igorlab/ph-simulator/docs/schematic.png

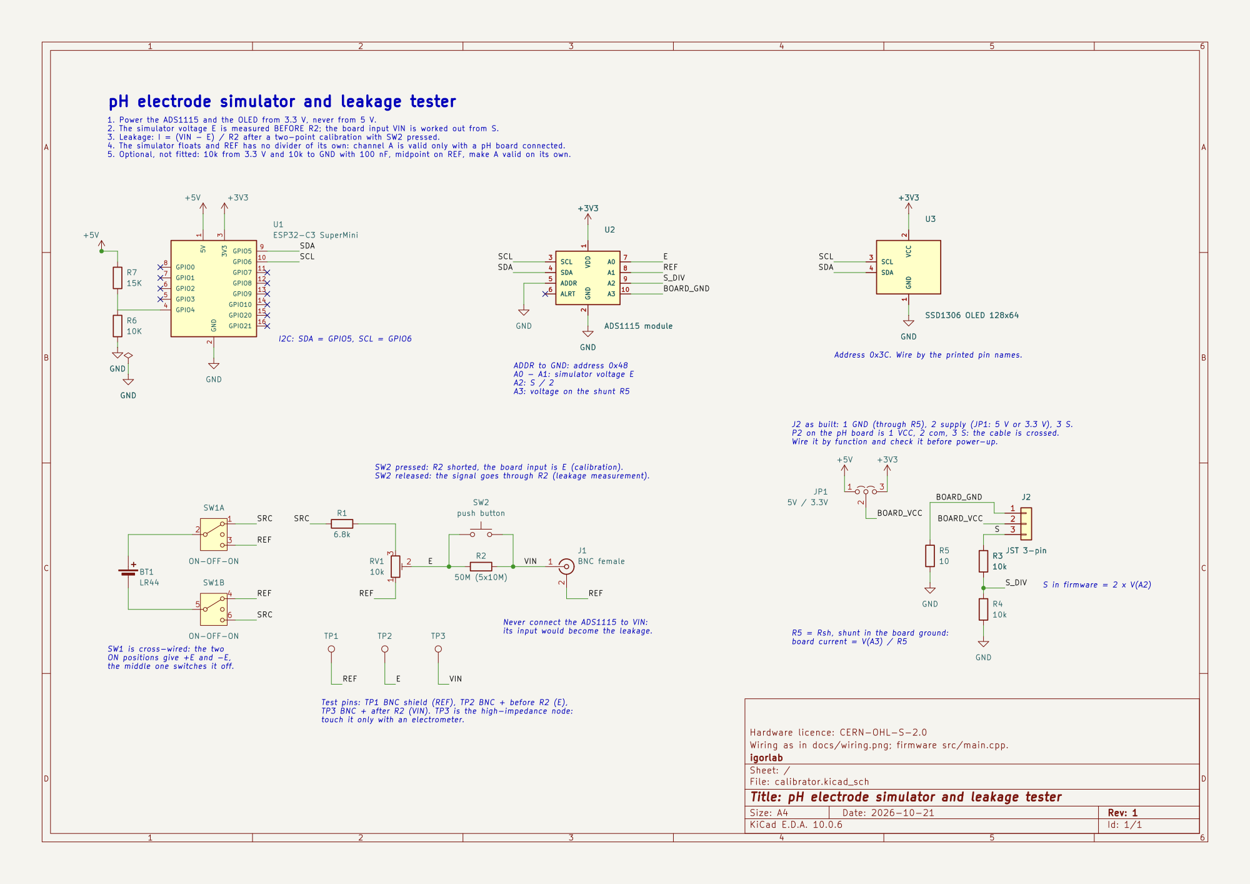
docs/schematic.png
