igorlab/ph-simulator/docs/schematic.pdf

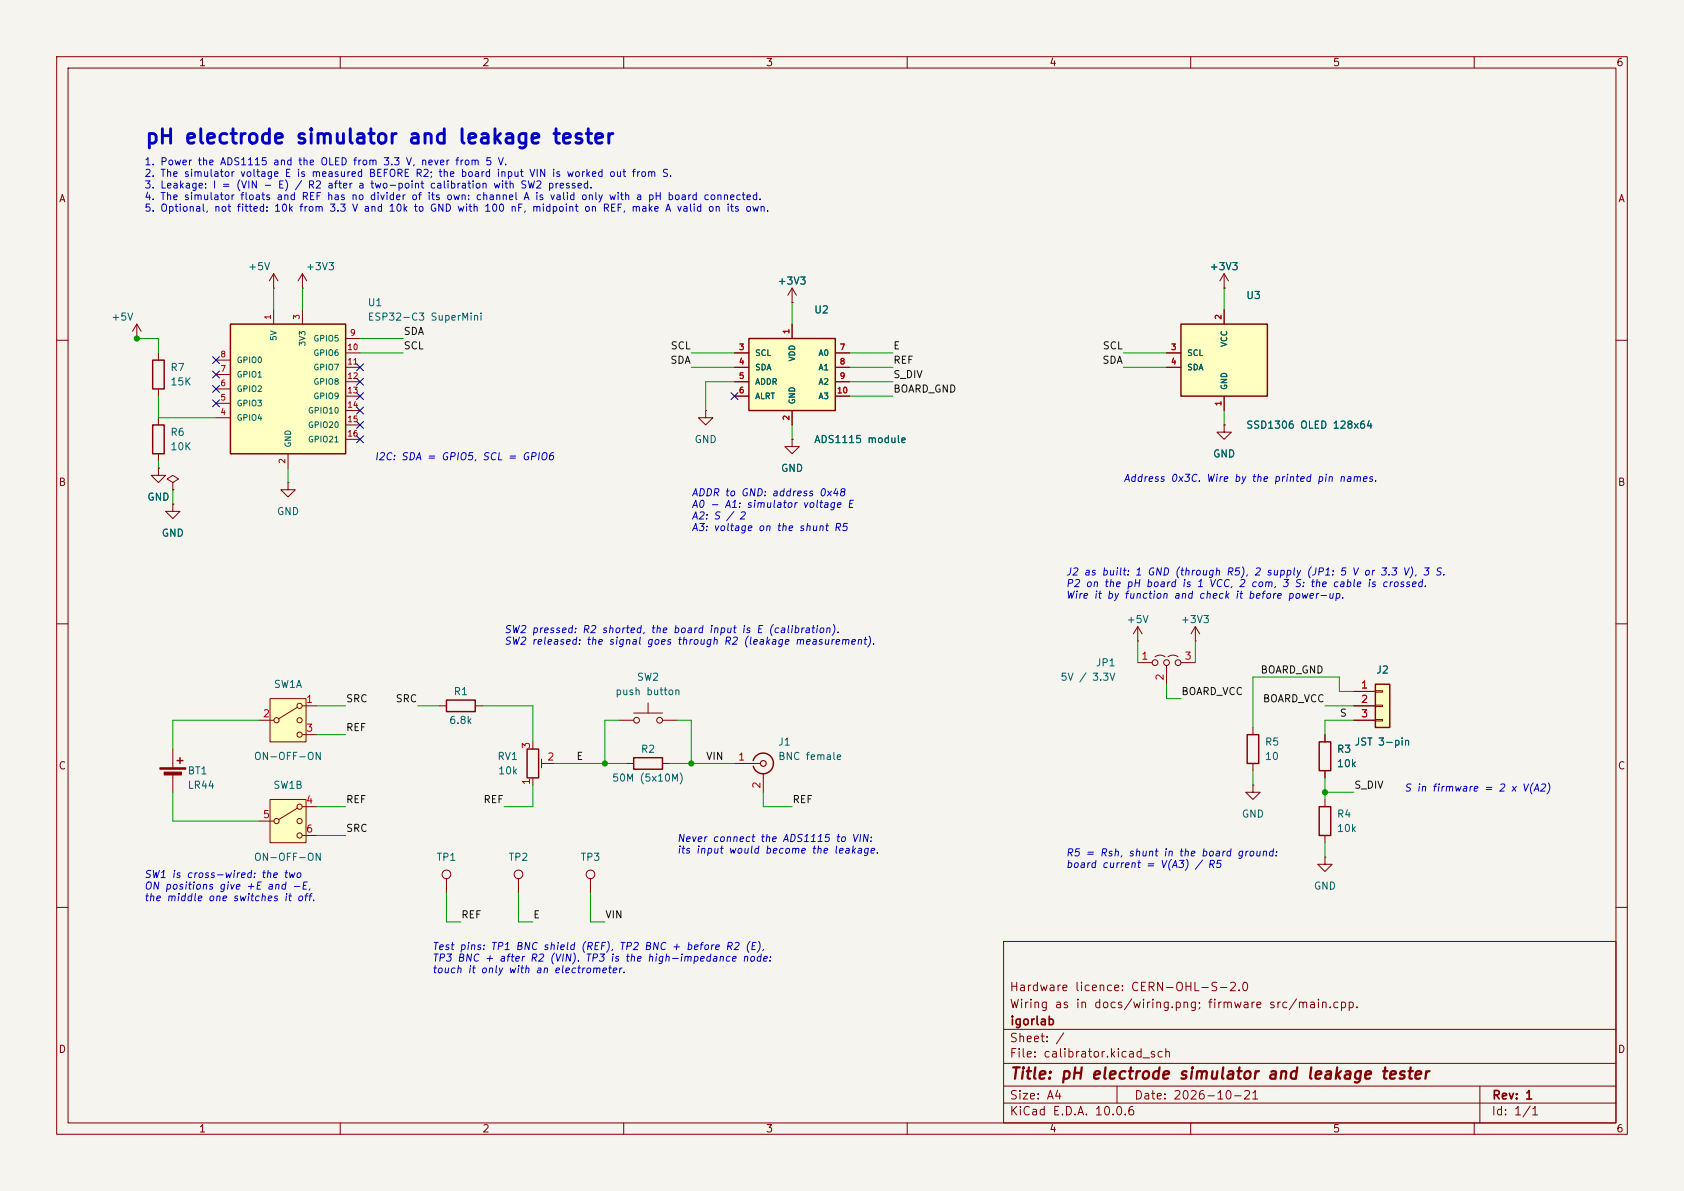
[picture p3: page 1]

1. Power the ADS1115 and the OLED from 3.3 V, never from 5 V. 2. The simulator voltage E is measured BEFORE R2; the board input VIN is worked out from S. 3. Leakage: I = (VIN - E) / R2 after a two-point calibration with SW2 pressed. 4. The simulator floats and REF has no divider of its own: channel A is valid only with a pH board connected. 5. Optional, not fitted: 10k from 3.3 V and 10k to GND with 100 nF, midpoint on REF, make A valid on its own. pH electrode simulator and leakage tester

its input would become the leakage. Test pins: TP1 BNC shield (REF), TP2 BNC + before R2 (E), TP3 BNC + after R2 (VIN). TP3 is the high-impedance node: touch it only with an electrometer. SW2 pressed: R2 shorted, the board input is E (calibration). SW2 released: the signal goes through R2 (leakage measurement). ADDR to GND: address 0x48

A0 - A1: simulator voltage E
A3: voltage on the shunt R5

SW1 is cross-wired: the two ON positions give +E and -E, the middle one switches it off.

Hardware licence: CERN-OHL-S-2.0
Wiring as in docs/wiring.png; firmware src/main.cpp.
igorlab
Sheet: /
File: calibrator.kicad_sch
Title: pH electrode simulator and leakage tester

Size: A4 | Rev: 1
KiCad E.D.A. 10.0.6 | Id: 1/1
