igorlab/ph-simulator/hardware/calibrator.kicad_sch

## KiCad design hardware/calibrator.kicad_sch (2026-10-27)

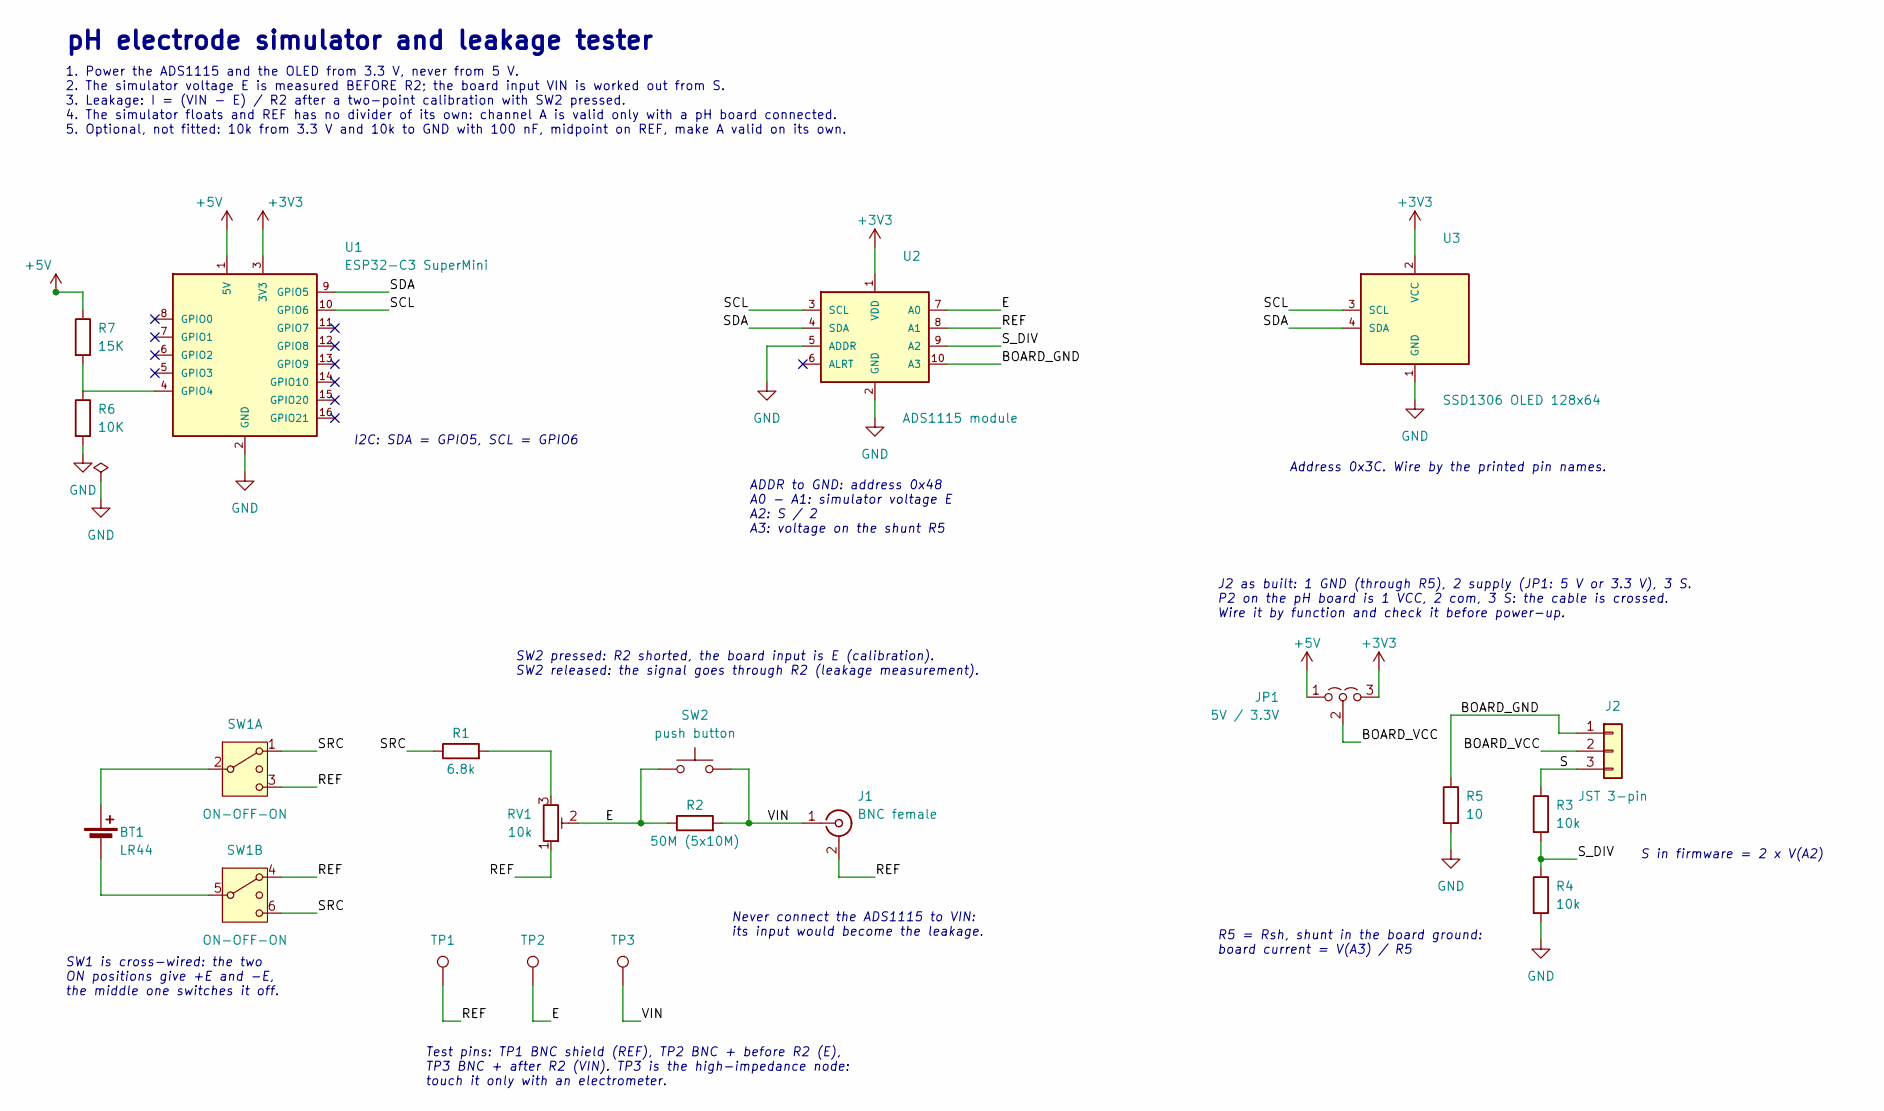
[picture p4: schematic calibrator.kicad_sch]

Parts:
BT1: LR44
J1: BNC female
J2: JST 3-pin
JP1: 5V / 3.3V
R1: 6.8k
R2: 50M (5x10M)
R3, R4: 10k
R5: 10
R6: 10K
R7: 15K
RV1: 10k
SW1: ON-OFF-ON
SW2: push button
TP1: REF
TP2: E
TP3: VIN
U1: ESP32-C3 SuperMini
U2: ADS1115 module
U3: SSD1306 OLED 128x64

Connections:
+3V3: JP1.3 (B), U1.3 (3V3), U2.1 (VDD), U3.2 (VCC)
+5V: JP1.1 (A), R7.1, U1.1 (5V)
BOARD_GND: J2.1, R5.1, U2.10 (A3)
BOARD_VCC: J2.2, JP1.2 (C)
E: R2.1, RV1.2, SW2.1, TP2.1, U2.7 (A0)
GND: R4.2, R5.2, R6.2, U1.2 (GND), U2.2 (GND), U2.5 (ADDR), U3.1 (GND)
unnamed: BT1.1 (+), SW1.2 (3)
unnamed: BT1.2 (-), SW1.5 (3)
unnamed: R1.2, RV1.3
unnamed: R6.1, R7.2, U1.4 (GPIO4)
REF: J1.2 (Ext), RV1.1, SW1.3 (4), SW1.4 (1), TP1.1, U2.8 (A1)
S: J2.3, R3.1
SCL: U1.10 (GPIO6), U2.3 (SCL), U3.3 (SCL)
SDA: U1.9 (GPIO5), U2.4 (SDA), U3.4 (SDA)
SRC: R1.1, SW1.1, SW1.6 (4)
S_DIV: R3.2, R4.1, U2.9 (A2)
VIN: J1.1 (In), R2.2, SW2.2, TP3.1

Notes on the sheet:
Never connect the ADS1115 to VIN: its input would become the leakage.
I2C: SDA = GPIO5, SCL = GPIO6
S in firmware = 2 x V(A2)
Test pins: TP1 BNC shield (REF), TP2 BNC + before R2 (E), TP3 BNC + after R2 (VIN). TP3 is the high-impedance node: touch it only with an electrometer.
R5 = Rsh, shunt in the board ground: board current = V(A3) / R5
SW1 is cross-wired: the two ON positions give +E and -E, the middle one switches it off.
SW2 pressed: R2 shorted, the board input is E (calibration). SW2 released: the signal goes through R2 (leakage measurement).
ADDR to GND: address 0x48 A0 - A1: simulator voltage E A2: S / 2 A3: voltage on the shunt R5
J2 as built: 1 GND (through R5), 2 supply (JP1: 5 V or 3.3 V), 3 S. P2 on the pH board is 1 VCC, 2 com, 3 S: the cable is crossed. Wire it by function and check it before power-up.
pH electrode simulator and leakage tester
Address 0x3C. Wire by the printed pin names.
1. Power the ADS1115 and the OLED from 3.3 V, never from 5 V. 2. The simulator voltage E is measured BEFORE R2; the board input VIN is worked out from S. 3. Leakage: I = (VIN - E) / R2 after a two-point calibration with SW2 pressed. 4. The simulator floats and REF has no divider of its own: channel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
