igorlab/ph-simulator/(commit log)

2026-10-20 pH electrode simulator and leakage tester, firmware 1.1.1
    ESP32-C3 + ADS1115 + SSD1306 bench tool for pH-electrode boards: a battery
    simulator feeds a known voltage through a 50 MOhm resistor, the calibrator
    fits the board's E -> S line from two points and shows its input leakage
    current. OLED and an EN/UA web page with live charts; Wi-Fi set from the
    page; all versions pinned.
    [main.cpp]
2026-10-20 Wiring diagram: S in firmware is 2 x V(A2)
2026-10-21 Open licences, KiCad schematic, VMID back in the wiring diagram
    - Licences: hardware CERN-OHL-S v2, firmware GPL-3.0-or-later, docs and
    images CC BY-SA 4.0 (was CC BY-NC-SA 4.0). See LICENSE and LICENSES/.
    - hardware/: KiCad 10 schematic of the calibrator; docs/schematic.pdf/.png.
    - docs/wiring.png: the VMID divider (R6, R7 10 kOhm from 3.3 V, C1 100 nF)
    on A1 and the simulator reference is back. The working calibrator has it;
    the previous drawing had lost the connection.
    - README: schematic link, VMID in the parts table.
    [calibrator.kicad_sch]
2026-10-21 No VMID divider, crossed cable: the schematic and wiring diagram match the built unit
    An ohmmeter check found nothing between A1 and 3.3 V or GND: the calibrator has no
    VMID divider, and A1 floats until a pH board is connected. The divider added in
    f99d40c is removed from the KiCad schematic, the wiring diagram and the READMEs.
    Channel A is documented as valid only with a board connected, the divider as an
    optional addition. The 50 MΩ series resistor is five 10 MΩ SMD in series.
    The JST is numbered as built: 1 GND (through Rsh), 2 +5 V, 3 S. The pH board's P2 is
    VCC, com, S, so the cable between them is crossed; the docs say to wire it by function.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
    [calibrator.kicad_sch]
2026-10-22 Logger for measurements: every field of /data to CSV
    The page's «Download CSV» keeps only time, pH and S. tools/calibrator_log.py polls /data,
    which the page itself reads, once a second and writes every field - E, S, the board
    input, the leakage, the calibration line, R and the board current - with a mark column
    typed from the keyboard to tell the phases of an experiment apart. No firmware change.
2026-10-27 Add USB supply measurement to schematic and documentation
    [calibrator.kicad_sch]
2026-10-27 Show USB supply divider in wiring diagram
2026-10-27 Connect USB divider directly to GND, 5V, and GPIO4
2026-10-27 Correct ESP32 power-pin label in wiring diagram
2026-10-27 Update calibrator wiring diagram
